sneakylizard123-4/CS4344/images/pcb/render-bottom.png

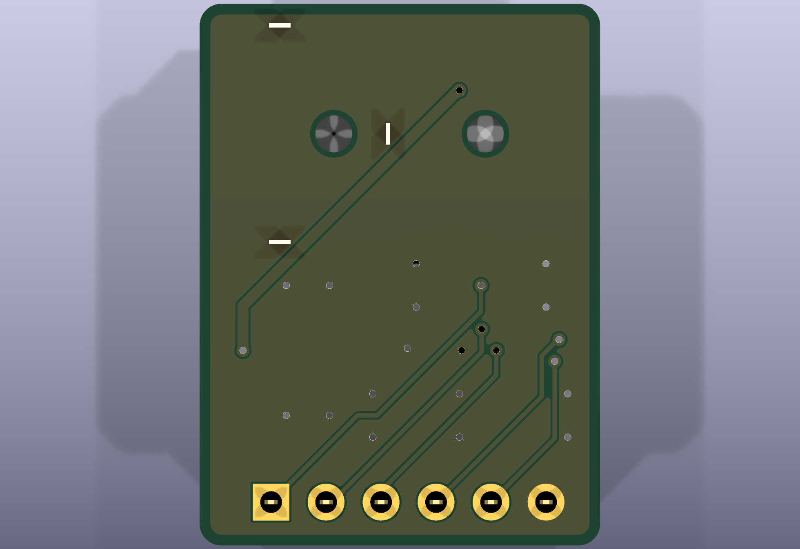
images/pcb/render-bottom.png
