sneakylizard123-4/CS4344/images/pcb/render-top.png

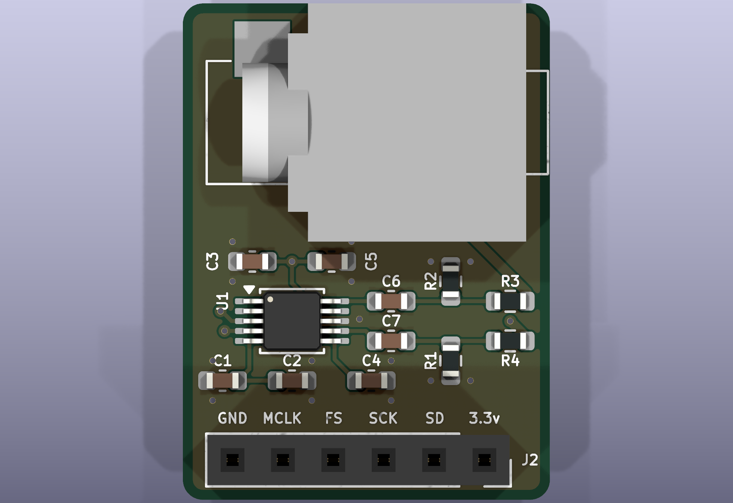
images/pcb/render-top.png
