sneakylizard123-4/CS4344/images/schematic/01-root.png

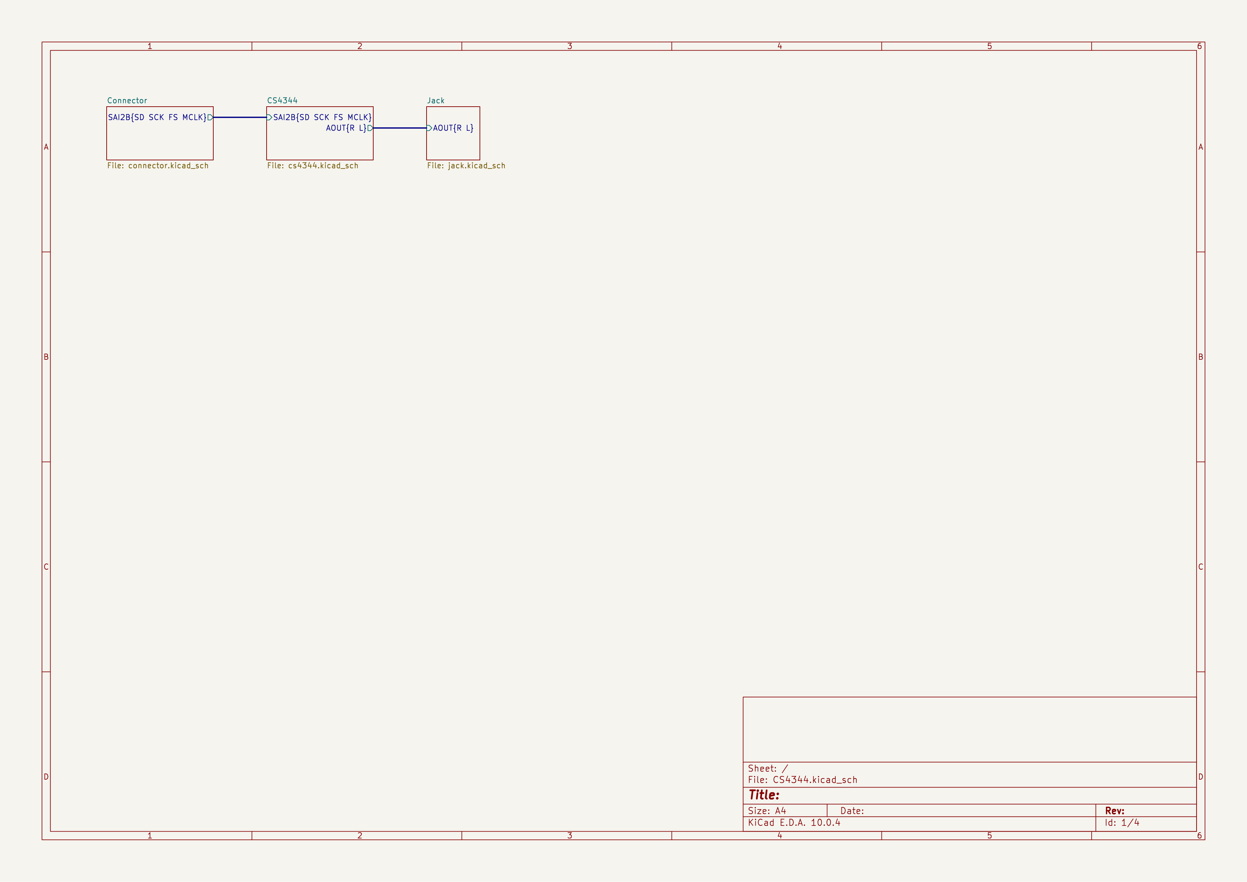
images/schematic/01-root.png
