sneakylizard123-4/CS4344/images/schematic/03-jack.png

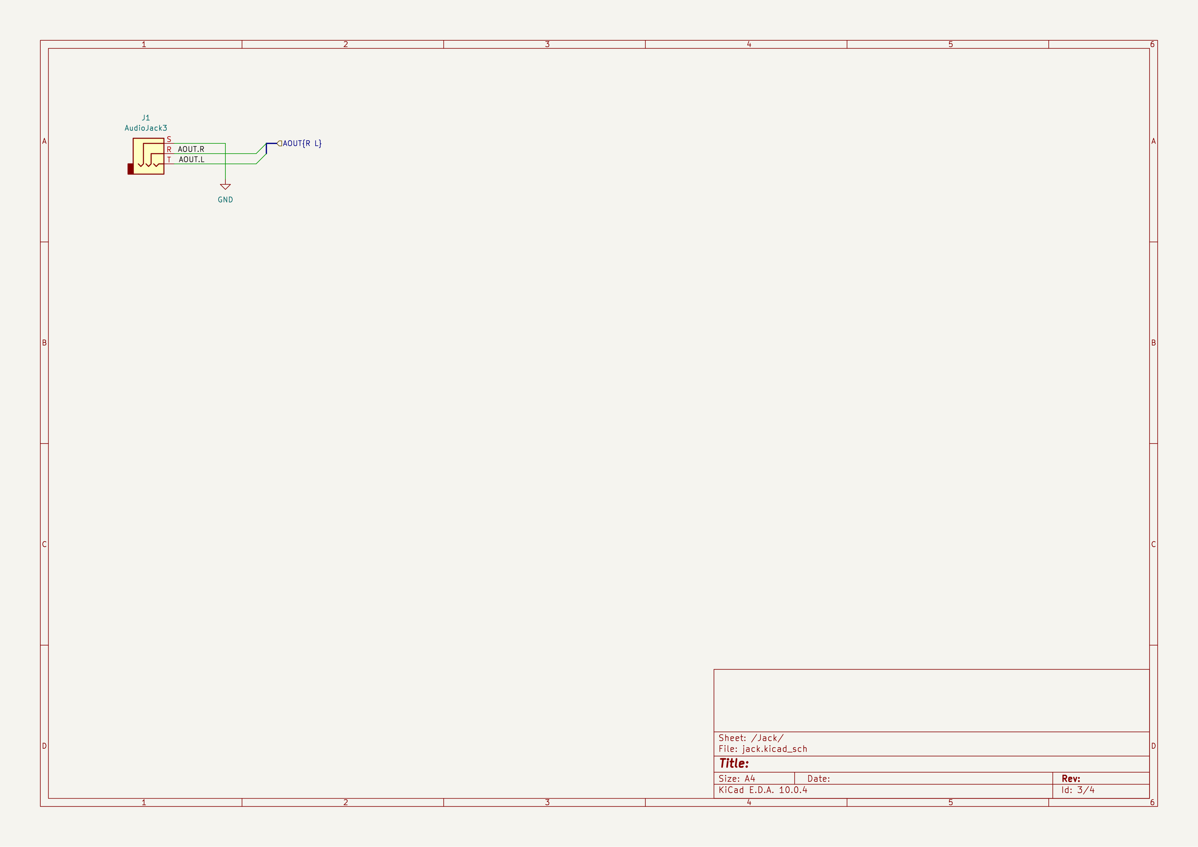
images/schematic/03-jack.png
