sneakylizard123-4/CS4344/images/schematic/04-connector.png

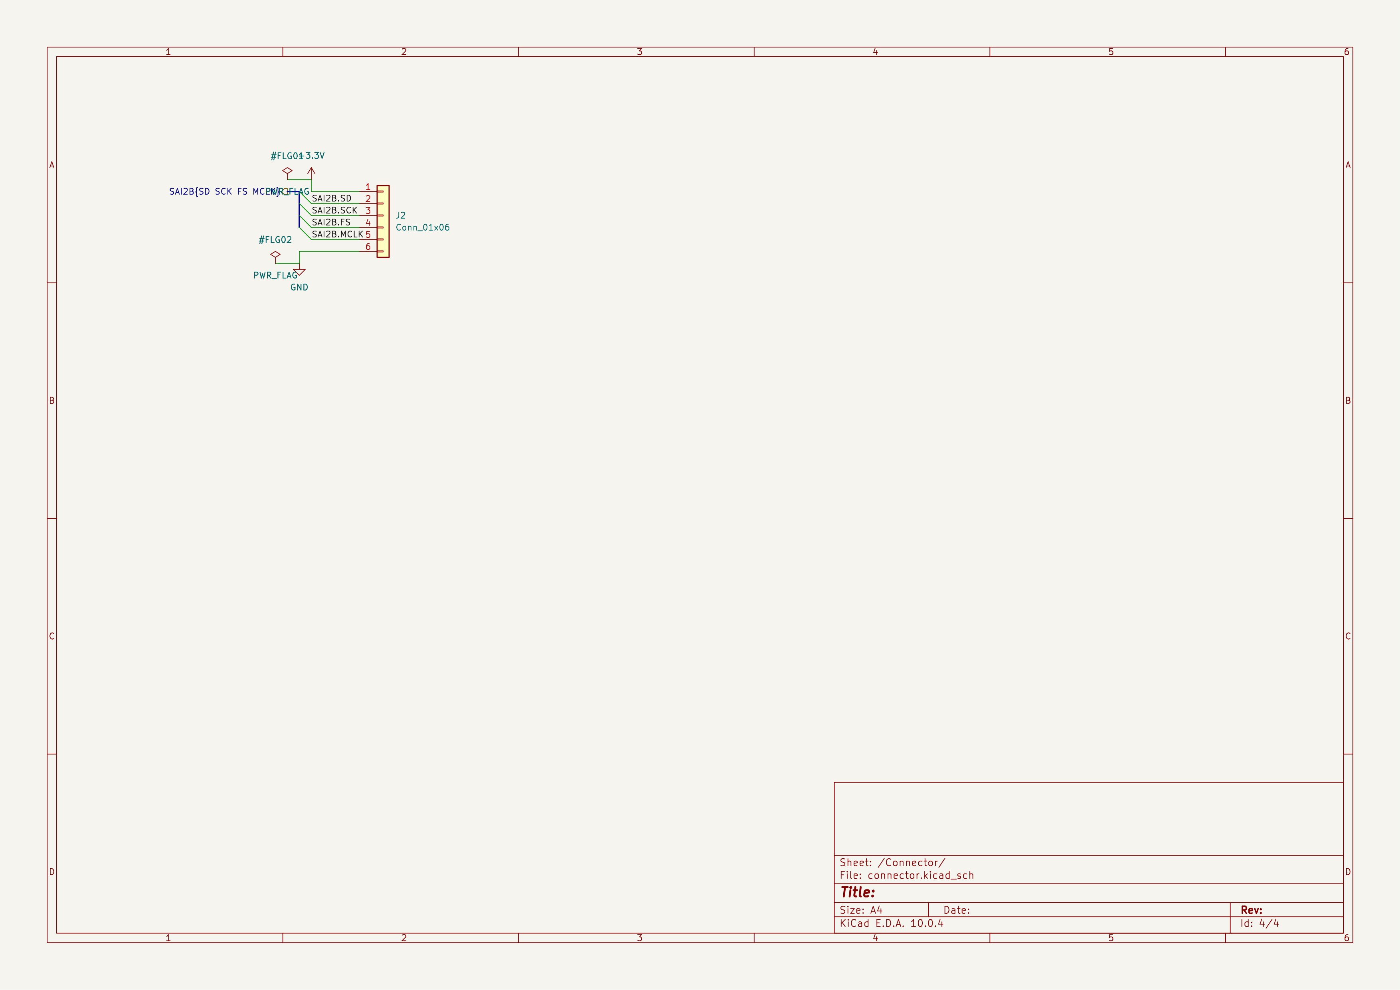
images/schematic/04-connector.png
