sneakylizard123-4/CS4344/images/screenshots/2026-1025-1109.png

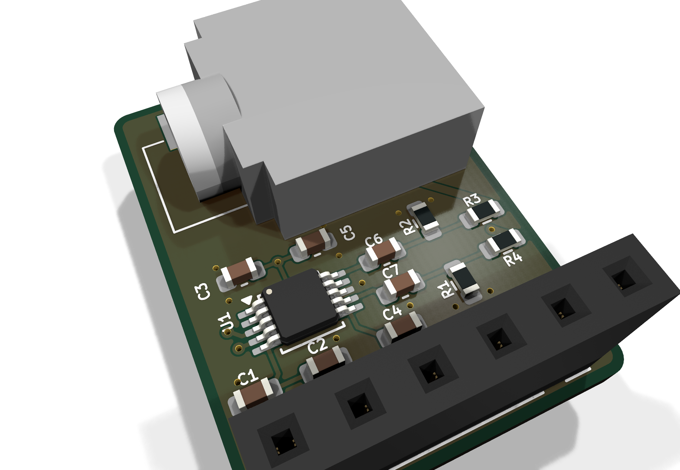
images/screenshots/2026-1025-1109.png
