sneakylizard123-4/CS4344/kicad/production/bom.csv

Designator | Footprint | Quantity | Value | LCSC Part #
C1, C4 | 0603 | 2 | 10uF | C19702
C2, C5 | 0603 | 2 | 0.1uF | C14663
C3 | 0603 | 1 | 1uF | C15849
C6, C7 | 0603 | 2 | 3.3uF | C51412
J1 | Jack_3.5mm_CUI_SJ-3523-SMT_Horizontal | 1 | AudioJack3
J2 | PinSocket_1x06_P2.54mm_Vertical | 1 | Conn_01x06 | C40877
R1, R2 | 0603 | 2 | 10k | C25804
R3, R4 | 0603 | 2 | 470 | C23179
U1 | TSSOP-10_3x3mm_P0.5mm | 1 | CS4344 | C8952
