sneakylizard123-4/CS4344/cad/CS4344-assembly.step

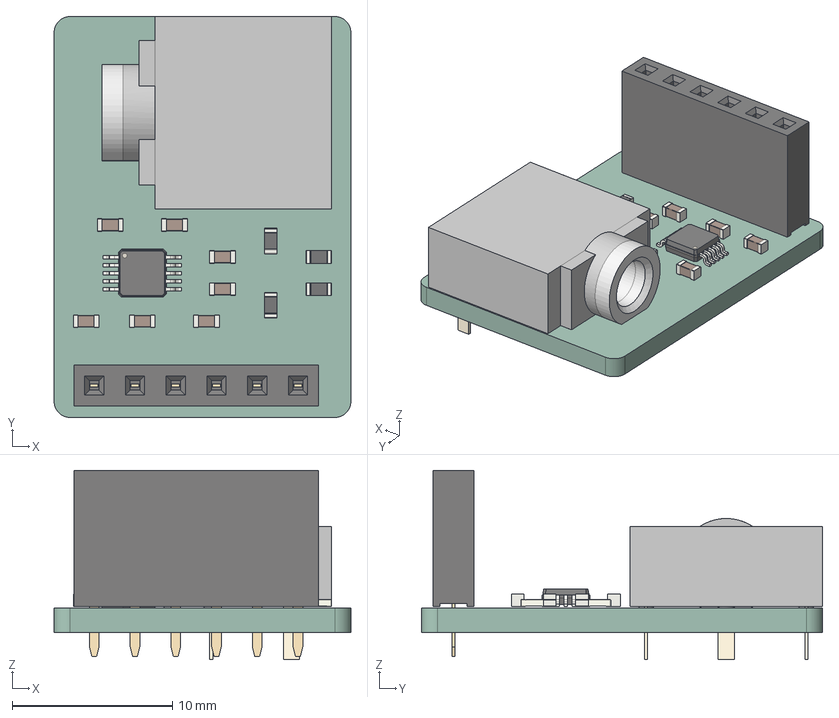
[picture p13: CAD file, 2026-10-25]
cad/CS4344-assembly.step
18.5 x 25.0 x 11.8 mm
PinSocket_1x06_P2.54mm_Vertical
C_0603_1608Metric x 7
R_0603_1608Metric x 4
TSSOP-10_3x3mm_P0.5mm
Jack_3.5mm_CUI_SJ1-3523N_Horizontal
CS4344_PCB
