sneakylizard123-4/CS4344/cad/CS4344-full-assembly.step

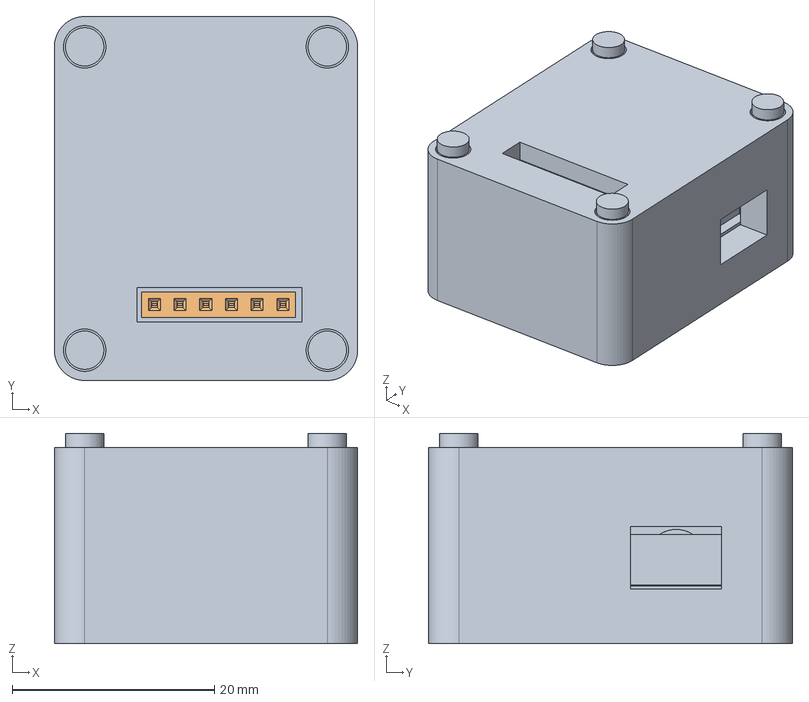
[picture p14: CAD file, 2026-10-25]
cad/CS4344-full-assembly.step
30.0 x 36.0 x 20.8 mm
