sneakylizard123-4/CS4344/cad/CS4344-enclosure-lid.step

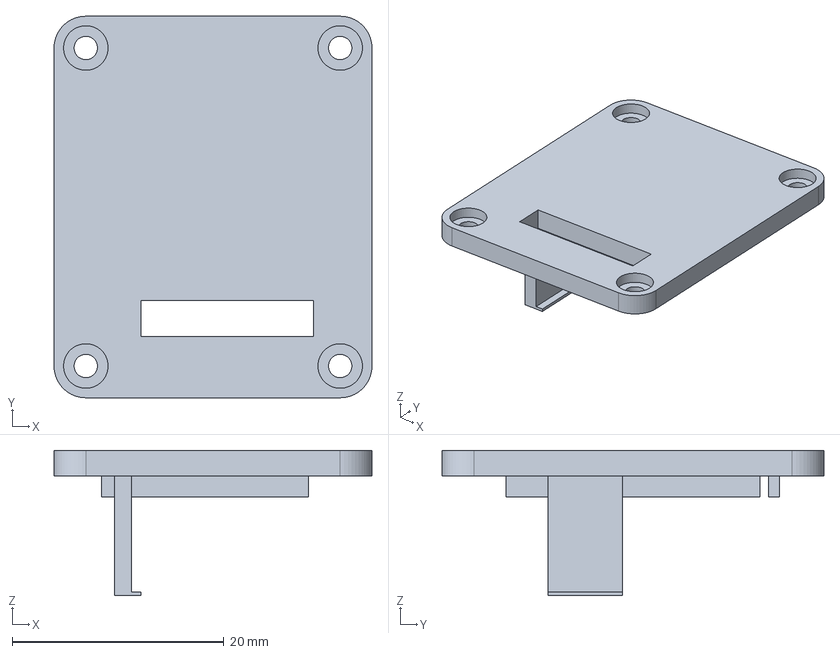
[picture p15: CAD file, 2026-10-25]
cad/CS4344-enclosure-lid.step
30.0 x 36.0 x 13.7 mm
