sneakylizard123-4/CS4344/cad/CS4344-enclosure-base.step

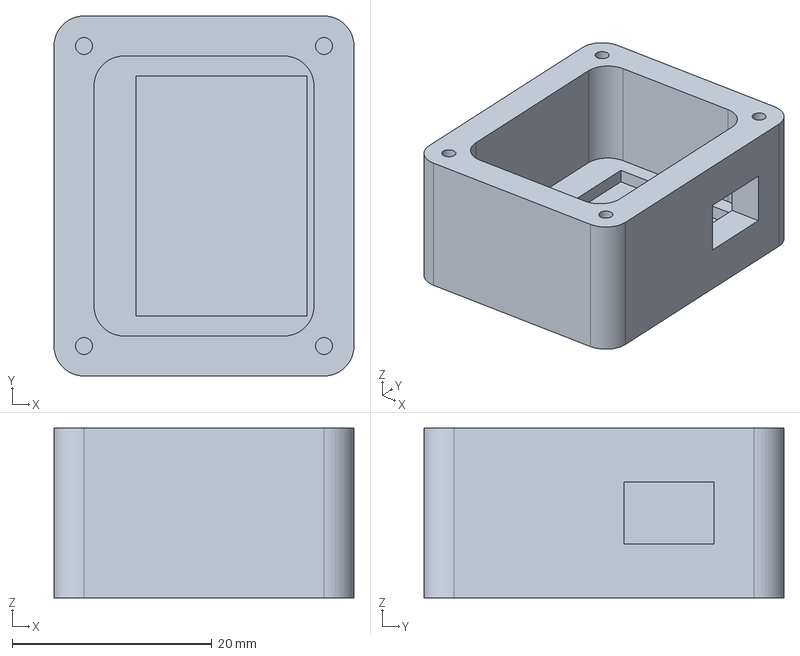
[picture p16: CAD file, 2026-10-25]
cad/CS4344-enclosure-base.step
30.0 x 36.0 x 17.0 mm
