sneakylizard123-4/CS4344/cad/CS4344-board.step

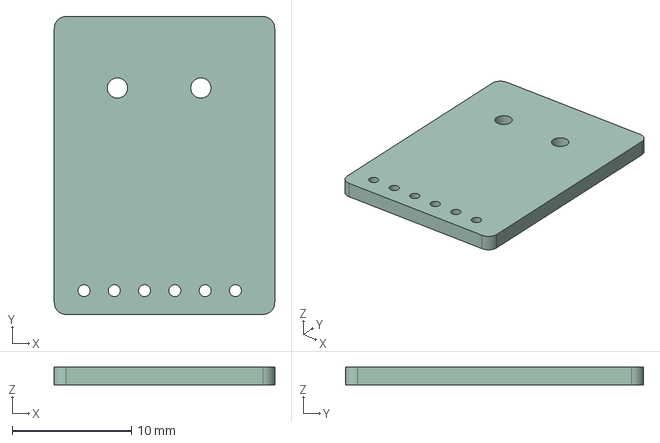
[picture p17: CAD file, 2026-10-25]
cad/CS4344-board.step
18.5 x 25.0 x 1.51 mm
