sneakylizard123-4/CS4344/(list of files, cad)

Other CAD files:
blender/CS4344.blend
cad/CS4344-enclosure-base.stl
cad/CS4344-enclosure-lid.stl
