sneakylizard123-4/CS4344/kicad/CS4344.kicad_pcb

## KiCad design kicad/CS4344.kicad_pcb (2026-10-25)

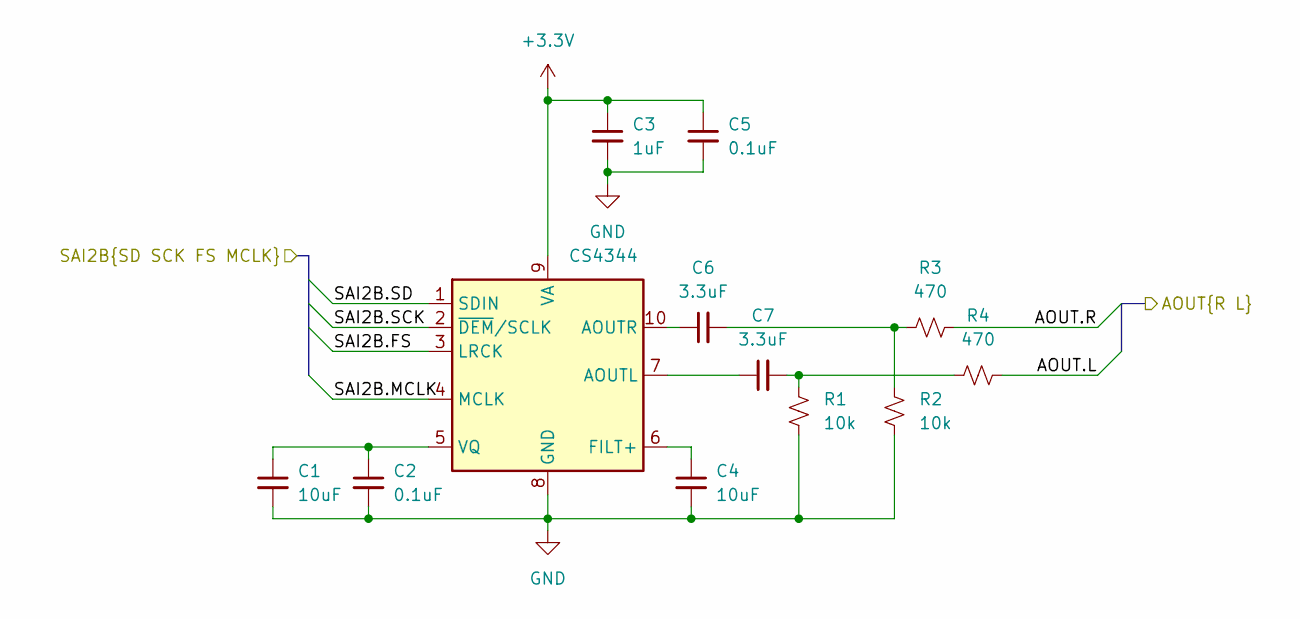
[picture p21: schematic cs4344.kicad_sch]

Parts:
C1, C4: 10uF; C_0603_1608Metric
C2, C5: 0.1uF; C_0603_1608Metric
C3: 1uF; C_0603_1608Metric
C6, C7: 3.3uF; C_0603_1608Metric
R1, R2: 10k; R_0603_1608Metric
R3, R4: 470; R_0603_1608Metric
U1: CS4344; TSSOP-10_3x3mm_P0.5mm

Connections:
+3.3V: C3.1, C5.1, U1.9 (VA); also elsewhere on the board
/CS4344/AOUT.L: R4.2; also elsewhere on the board
/CS4344/AOUT.R: R3.2; also elsewhere on the board
/CS4344/SAI2B.FS: U1.3 (LRCK); also elsewhere on the board
/CS4344/SAI2B.MCLK: U1.4 (MCLK); also elsewhere on the board
/CS4344/SAI2B.SCK: U1.2 (~DEM/SCLK); also elsewhere on the board
/CS4344/SAI2B.SD: U1.1 (SDIN); also elsewhere on the board
GND: C1.2, C2.2, C3.2, C4.2, C5.2, R1.2, R2.2, U1.8 (GND); also elsewhere on the board
unnamed: C6.2, R2.1, R3.1
unnamed: C7.2, R1.1, R4.1
unnamed: C7.1, U1.7 (AOUTL)
unnamed: C6.1, U1.10 (AOUTR)
unnamed: C4.1, U1.6 (FILT+)
unnamed: C1.1, C2.1, U1.5 (VQ)

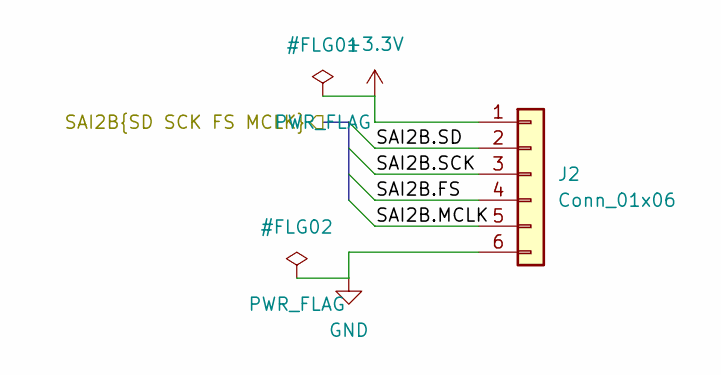
[picture p22: schematic connector.kicad_sch]

Parts:
J2: Conn_01x06; PinSocket_1x06_P2.54mm_Vertical

Connections:
+3.3V: J2.1; also elsewhere on the board
/CS4344/SAI2B.FS: J2.4; also elsewhere on the board
/CS4344/SAI2B.MCLK: J2.5; also elsewhere on the board
/CS4344/SAI2B.SCK: J2.3; also elsewhere on the board
/CS4344/SAI2B.SD: J2.2; also elsewhere on the board
GND: J2.6; also elsewhere on the board

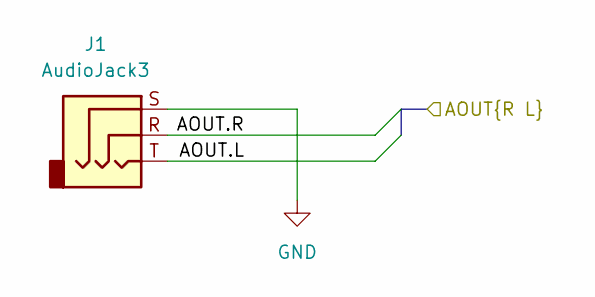
[picture p23: schematic jack.kicad_sch]

Parts:
J1: AudioJack3; Jack_3.5mm_CUI_SJ-3523-SMT_Horizontal

Connections:
/CS4344/AOUT.L: J1.T; also elsewhere on the board
/CS4344/AOUT.R: J1.R; also elsewhere on the board
GND: J1.S; also elsewhere on the board

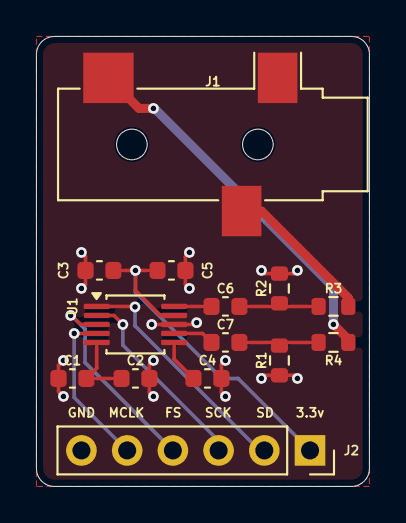
[picture p24: board CS4344.kicad_pcb from above]

Board: 2 copper layers, 18.5 x 25.0 mm, 14 parts (0 on the bottom side), 14 nets.
